ttmdear/gate-controller/kicad/board/board.kicad_pcb

## KiCad design kicad/board/board.kicad_pcb (2022-04-09)

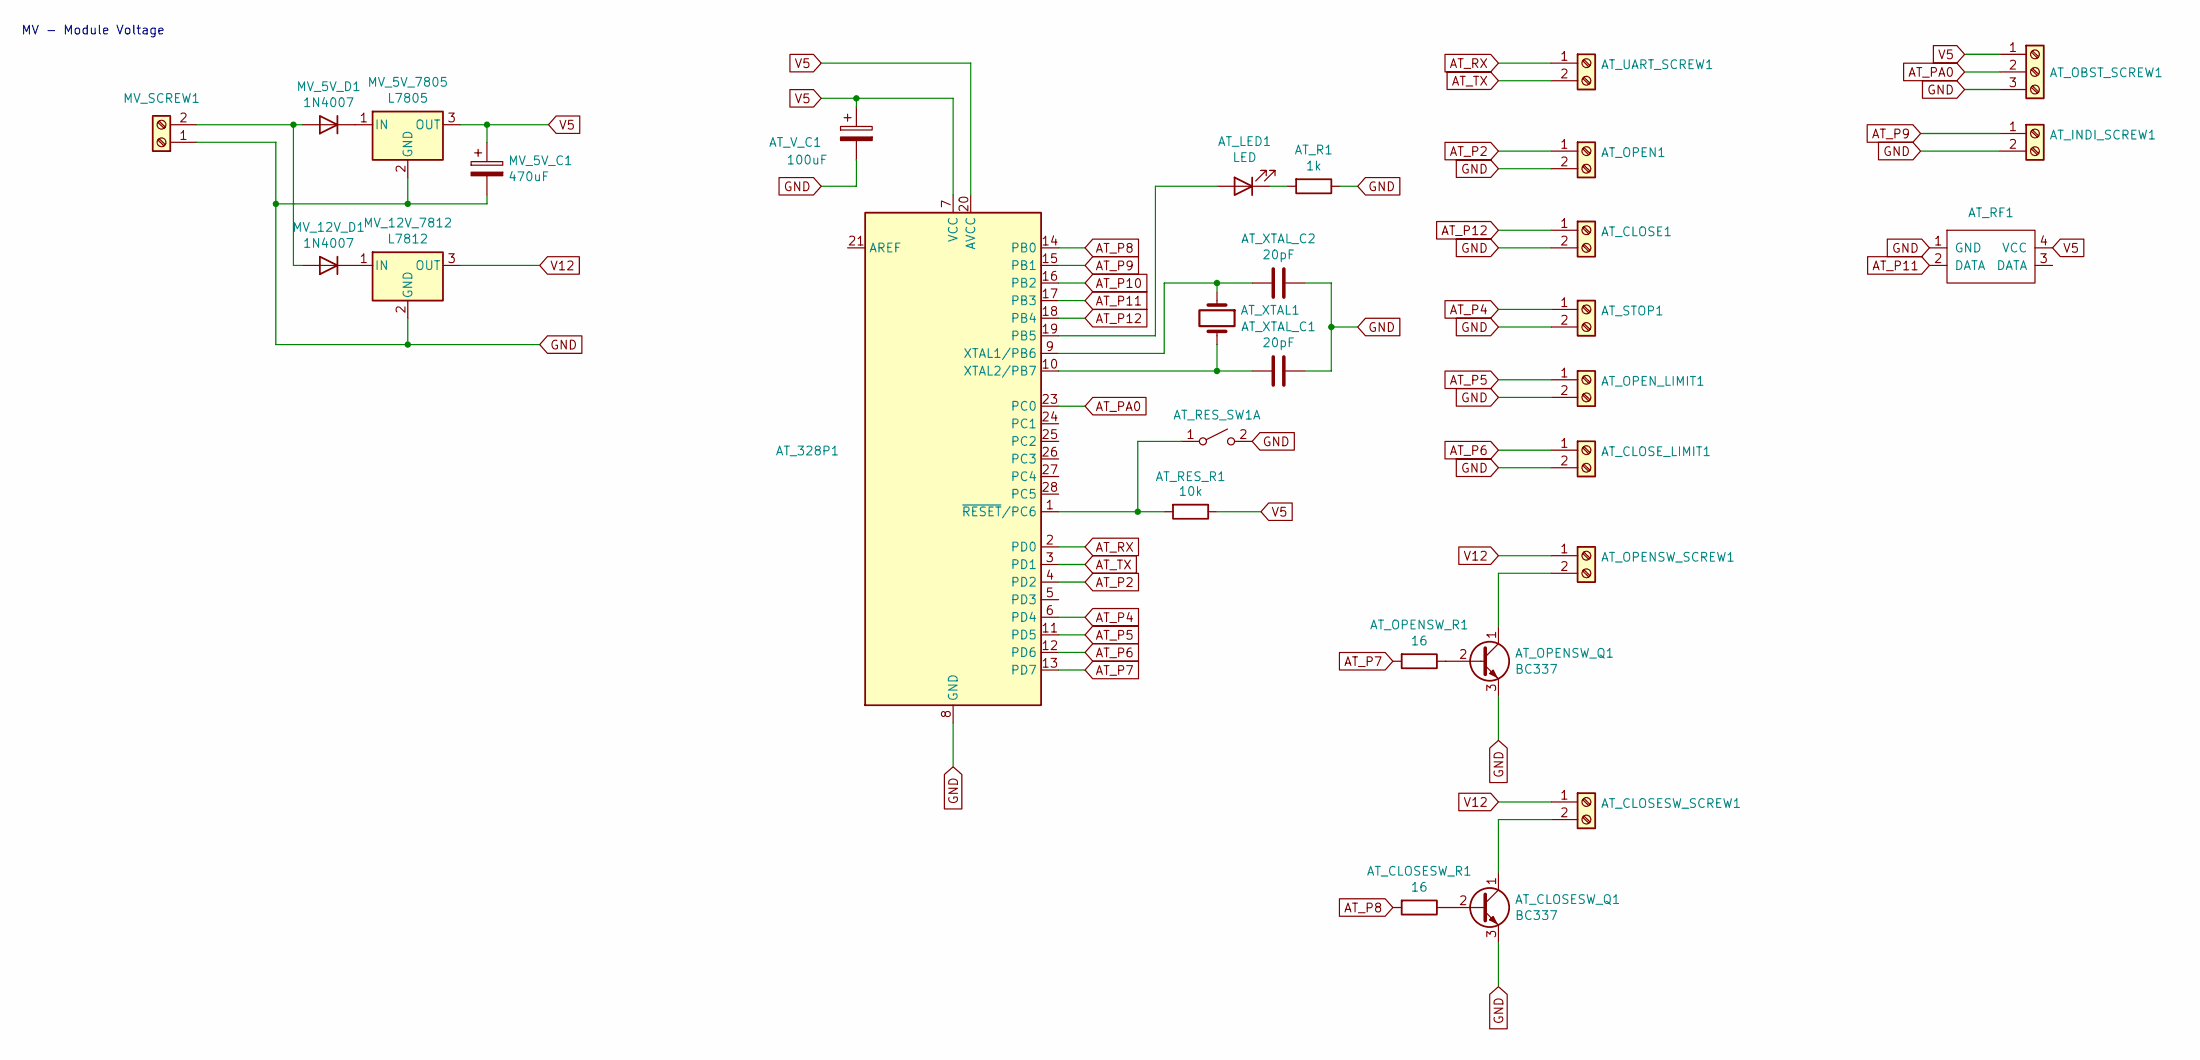
[picture p2: schematic board.sch]

Parts:
AT_328P1: http://www.microchip.com/filehandler/redirect?htt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; DIP-28_W7.62mm
AT_CLOSE1: Screw_Terminal_01x02; TerminalBlock_bornier-2_P5.08mm
AT_CLOSESW_Q1: BC337; TO-92
AT_CLOSESW_R1: 16; R_Axial_DIN0204_L3.6mm_D1.6mm_P5.08mm_Horizontal
AT_CLOSESW_SCREW1: Screw_Terminal_01x02; TerminalBlock_bornier-2_P5.08mm
AT_CLOSE_LIMIT1: Screw_Terminal_01x02; TerminalBlock_bornier-2_P5.08mm
AT_INDI_SCREW1: Screw_Terminal_01x02; TerminalBlock_bornier-2_P5.08mm
AT_LED1: LED; LED_D5.0mm
AT_OBST_SCREW1: Screw_Terminal_01x03; TerminalBlock_bornier-3_P5.08mm
AT_OPEN1: Screw_Terminal_01x02; TerminalBlock_bornier-2_P5.08mm
AT_OPENSW_Q1: BC337; TO-92
AT_OPENSW_R1: 16; R_Axial_DIN0204_L3.6mm_D1.6mm_P5.08mm_Horizontal
AT_OPENSW_SCREW1: Screw_Terminal_01x02; TerminalBlock_bornier-2_P5.08mm
AT_OPEN_LIMIT1: Screw_Terminal_01x02; TerminalBlock_bornier-2_P5.08mm
AT_R1: 1k; R_Axial_DIN0204_L3.6mm_D1.6mm_P2.54mm_Vertical
AT_RES_R1: 10k; R_Axial_DIN0204_L3.6mm_D1.6mm_P5.08mm_Horizontal
AT_RES_SW1: 1; SW_PUSH_6mm
AT_RF1: RF_RX_433MHz
AT_STOP1: Screw_Terminal_01x02; TerminalBlock_bornier-2_P5.08mm
AT_UART_SCREW1: Screw_Terminal_01x02; TerminalBlock_bornier-2_P5.08mm
AT_V_C1: 100uF; CP_Radial_D8.0mm_P5.00mm
AT_XTAL1: Crystal; Resonator-2Pin_W6.0mm_H3.0mm
AT_XTAL_C1, AT_XTAL_C2: 20pF; CP_Radial_D8.0mm_P3.80mm
MV_5V_7805: L7805; TO-220-3_Vertical
MV_5V_C1: 470uF; CP_Radial_D8.0mm_P5.00mm
MV_5V_D1, MV_12V_D1: 1N4007; D_T-1_P5.08mm_Horizontal
MV_12V_7812: L7812; TO-220-3_Vertical
MV_SCREW1: 12V; TerminalBlock_bornier-2_P5.08mm

Connections:
AT_P2: AT_328P1.4 (PD2), AT_OPEN1.1
AT_P4: AT_328P1.6 (PD4), AT_STOP1.1
AT_P5: AT_328P1.11 (PD5), AT_OPEN_LIMIT1.1
AT_P6: AT_328P1.12 (PD6), AT_CLOSE_LIMIT1.1
AT_P7: AT_328P1.13 (PD7), AT_OPENSW_R1.2
AT_P8: AT_328P1.14 (PB0), AT_CLOSESW_R1.2
AT_P9: AT_328P1.15 (PB1), AT_INDI_SCREW1.1
AT_P10: AT_328P1.16 (PB2)
AT_P11: AT_328P1.17 (PB3), AT_RF1.2 (DATA)
AT_P12: AT_328P1.18 (PB4), AT_CLOSE1.1
AT_PA0: AT_328P1.23 (PC0), AT_OBST_SCREW1.2
AT_RX: AT_328P1.2 (PD0), AT_UART_SCREW1.1
AT_TX: AT_328P1.3 (PD1), AT_UART_SCREW1.2
GND: AT_328P1.8 (GND), AT_328P1.22 (GND), AT_CLOSE1.2, AT_CLOSESW_Q1.3 (E), AT_CLOSE_LIMIT1.2, AT_INDI_SCREW1.2, AT_OBST_SCREW1.3, AT_OPEN1.2, AT_OPENSW_Q1.3 (E), AT_OPEN_LIMIT1.2, AT_R1.1, AT_RES_SW1.2 (B), AT_RF1.1 (GND), AT_STOP1.2, AT_V_C1.2, AT_XTAL_C1.1, AT_XTAL_C2.1, MV_5V_7805.2 (GND), MV_5V_C1.2, MV_12V_7812.2 (GND), MV_SCREW1.1
unnamed: AT_328P1.1 (~RESET~/PC6), AT_RES_R1.2, AT_RES_SW1.1 (A)
unnamed: AT_328P1.9 (XTAL1/PB6), AT_XTAL1.1, AT_XTAL_C2.2
unnamed: AT_328P1.10 (XTAL2/PB7), AT_XTAL1.2, AT_XTAL_C1.2
unnamed: AT_328P1.19 (PB5), AT_LED1.2 (A)
unnamed: AT_CLOSESW_Q1.1 (C), AT_CLOSESW_SCREW1.2
unnamed: AT_CLOSESW_Q1.2 (B), AT_CLOSESW_R1.1
unnamed: AT_LED1.1 (K), AT_R1.2
unnamed: AT_OPENSW_Q1.1 (C), AT_OPENSW_SCREW1.2
unnamed: AT_OPENSW_Q1.2 (B), AT_OPENSW_R1.1
unnamed: MV_5V_7805.1 (IN), MV_5V_D1.1 (K)
unnamed: MV_12V_7812.1 (IN), MV_12V_D1.1 (K)
unnamed: MV_5V_D1.2 (A), MV_12V_D1.2 (A), MV_SCREW1.2
V5: AT_328P1.7 (VCC), AT_328P1.20 (AVCC), AT_OBST_SCREW1.1, AT_RES_R1.1, AT_RF1.4 (VCC), AT_V_C1.1, MV_5V_7805.3 (OUT), MV_5V_C1.1
V12: AT_CLOSESW_SCREW1.1, AT_OPENSW_SCREW1.1, MV_12V_7812.3 (OUT)

Notes on the sheet:
MV - Module Voltage

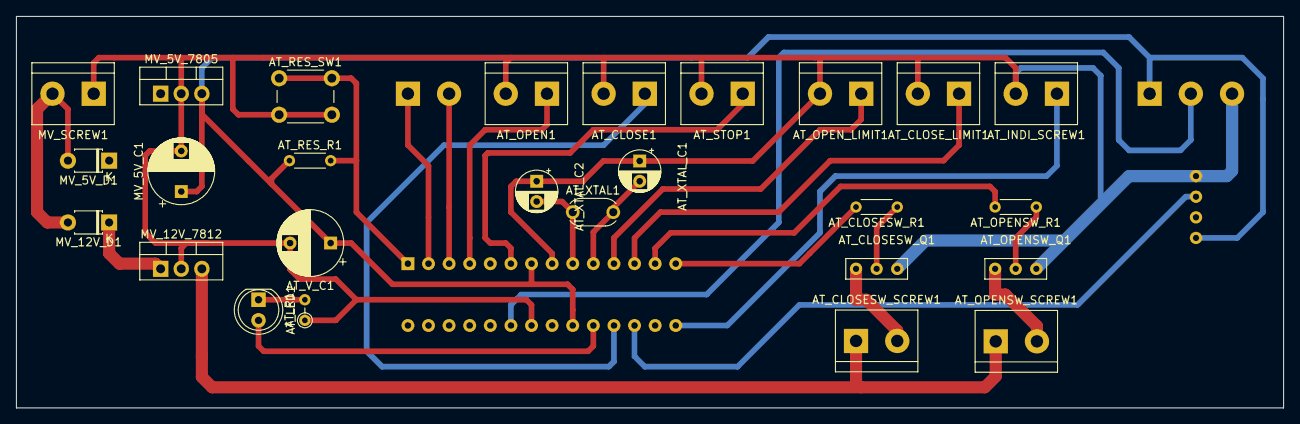
[picture p3: board board.kicad_pcb from above]

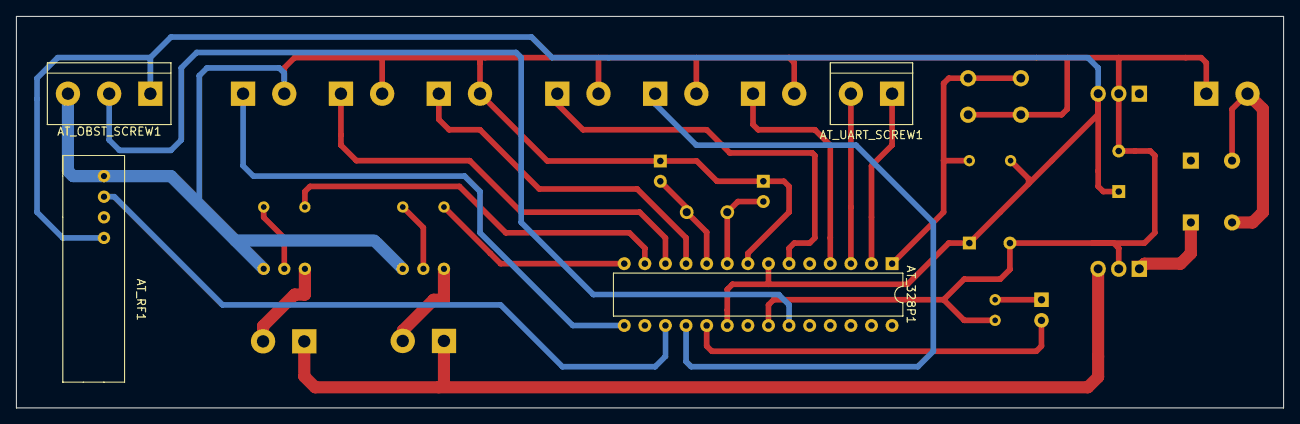
[picture p4: board board.kicad_pcb from below]

Board: 2 copper layers, 156.2 x 48.3 mm, 30 parts (4 on the bottom side), 27 nets.
