ttmdear/gate-controller/src/gate-controller-pilot-v3/gate-controller-pilot-v3.ino

#include <VirtualWire.h>
#include <VirtualWire_Config.h>

#define PIN_CLOSE 2
#define PIN_OPEN 3
#define PIN_STOP 4

const char* COMMAND_OPEN = "open";
const char* COMMAND_CLOSE = "close";
const char* COMMAND_STOP = "stop";

void sendCommand(const char* const command) {
    Serial.print("sendCommand ");
    Serial.println(command);

    vw_send((uint8_t *)command, strlen(command));
    vw_wait_tx();
}

void setup() {
    Serial.begin(9600);

    Serial.println("setup");
    vw_set_ptt_inverted(true);
    vw_setup(2000);

    pinMode(PIN_CLOSE, INPUT);
    pinMode(PIN_OPEN, INPUT);
    pinMode(PIN_STOP, INPUT);
}

int i=0;
void loop() {
    Serial.print("loop ");Serial.println(i);
    i++;

    if (digitalRead(PIN_OPEN) == HIGH) {
        sendCommand(COMMAND_OPEN);
    } else if (digitalRead(PIN_STOP) == HIGH) {
        sendCommand(COMMAND_STOP);
    } else if (digitalRead(PIN_CLOSE) == HIGH) {
        sendCommand(COMMAND_CLOSE);
    }

    delay(500);
}
