ttmdear/gate-controller/src/gate-controller-board/include/Test.h

#ifndef GATE_CONTROLLER_BOARD_TEST_H
#define GATE_CONTROLLER_BOARD_TEST_H

#include <Arduino.h>

class Test {
public:
    void testInput();

    void testOutput();

    void run();
};

#endif //GATE_CONTROLLER_BOARD_TEST_H
